ExquisiteCatBread/SpringReverb/README.md

# SpringReverb
Guitar effect based on reverb tank

See "Spring reverb project documentation.pdf"

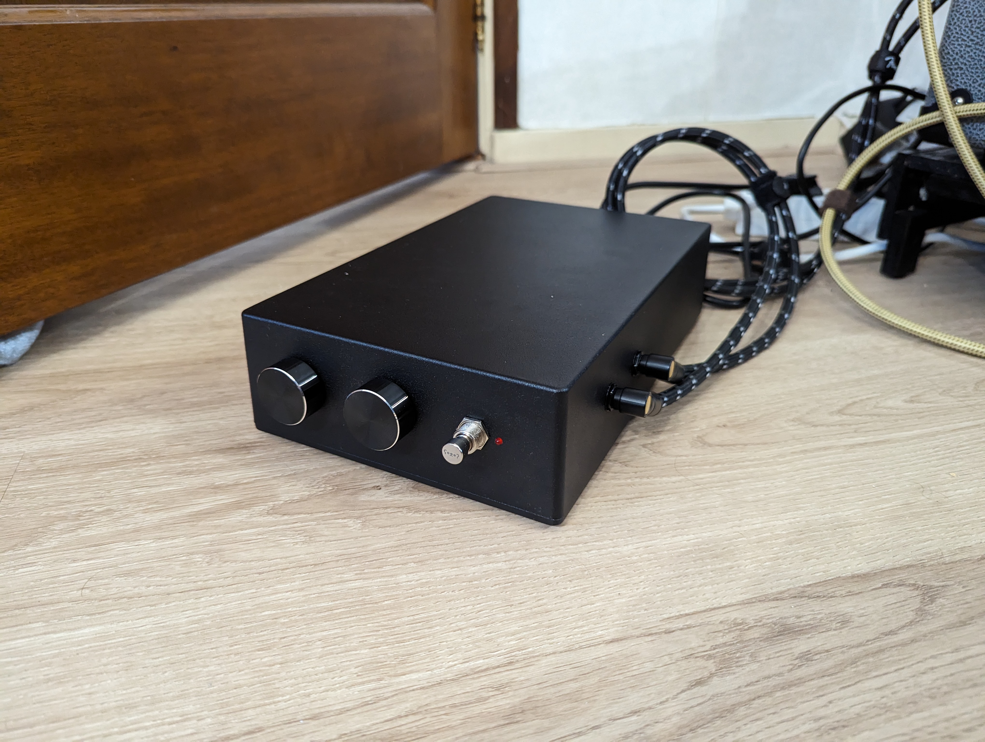
[picture p1: Pictures/SpringReverb(14).jpg]
SpringReverb
