ExquisiteCatBread/SpringReverb/Pictures/SpringReverb(1).jpg

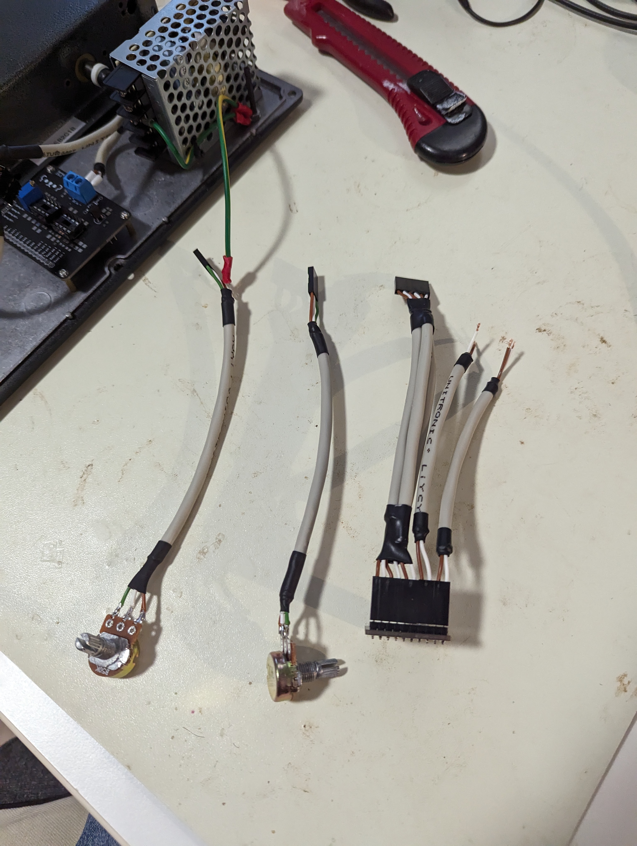
Pictures/SpringReverb(1).jpg
