ExquisiteCatBread/SpringReverb/Pictures/SpringReverb(2).jpg

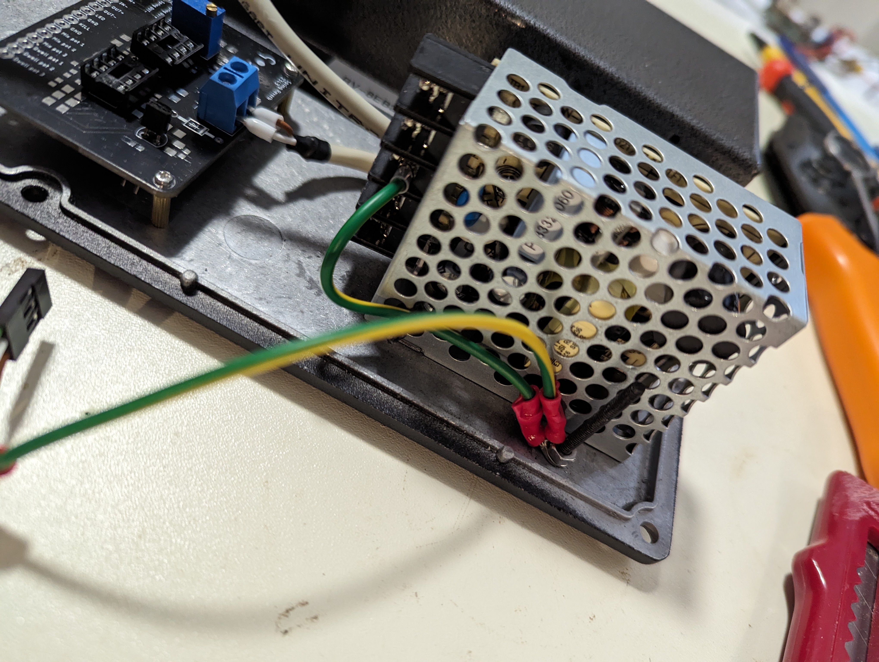
Pictures/SpringReverb(2).jpg
