ExquisiteCatBread/SpringReverb/Pictures/SpringReverb(3).jpg

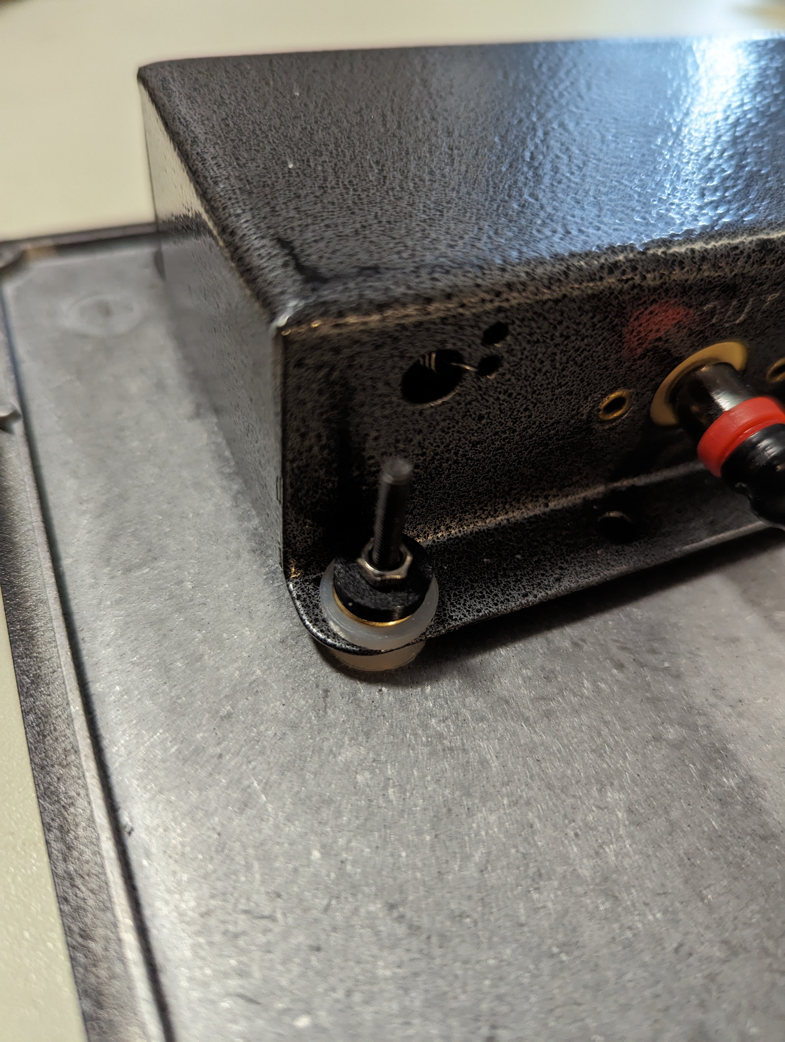
Pictures/SpringReverb(3).jpg
