ExquisiteCatBread/SpringReverb/Pictures/SpringReverb(4).jpg

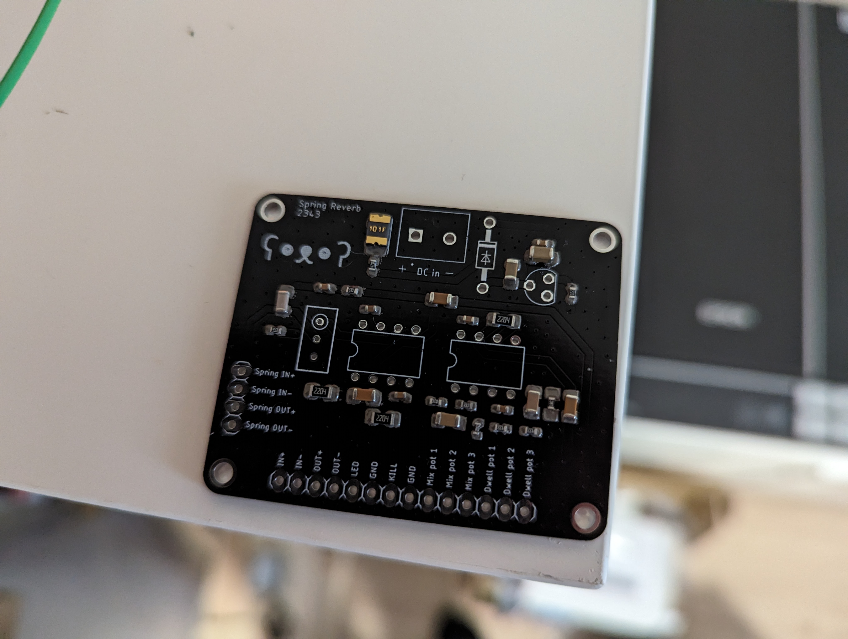
Pictures/SpringReverb(4).jpg
