ExquisiteCatBread/SpringReverb/Pictures/SpringReverb(5).jpg

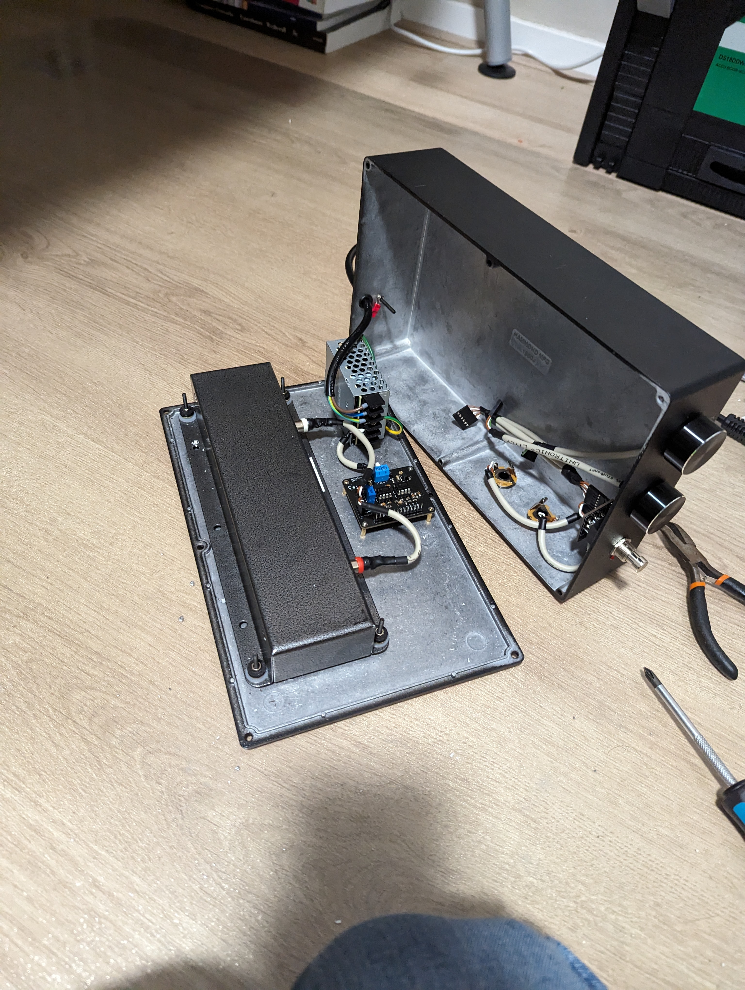
Pictures/SpringReverb(5).jpg
