ExquisiteCatBread/SpringReverb/Pictures/SpringReverb(6).jpg

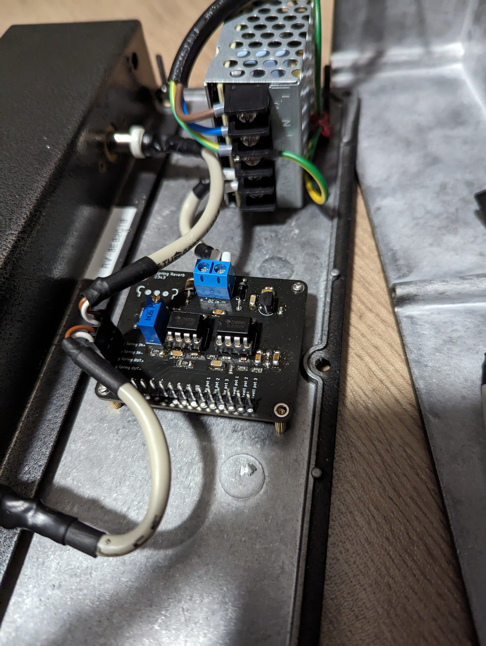
Pictures/SpringReverb(6).jpg
