ExquisiteCatBread/SpringReverb/Pictures/SpringReverb(7).jpg

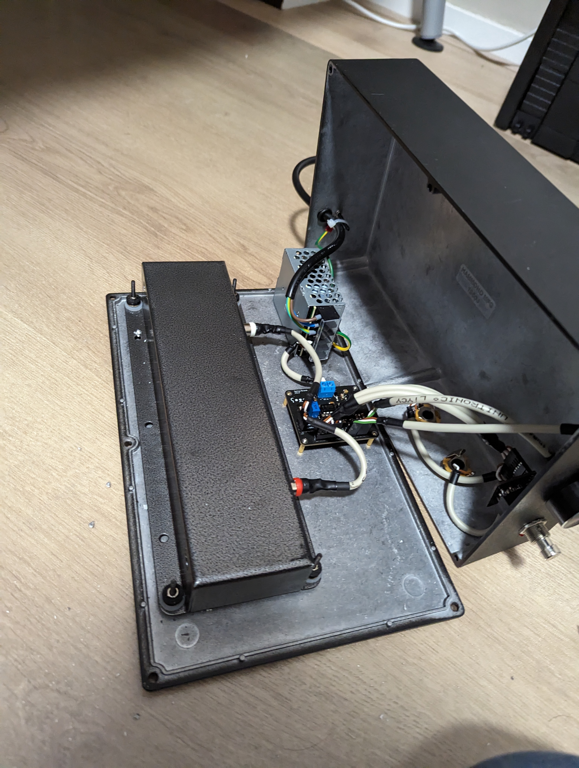
Pictures/SpringReverb(7).jpg
