ExquisiteCatBread/SpringReverb/Pictures/SpringReverb(8).jpg

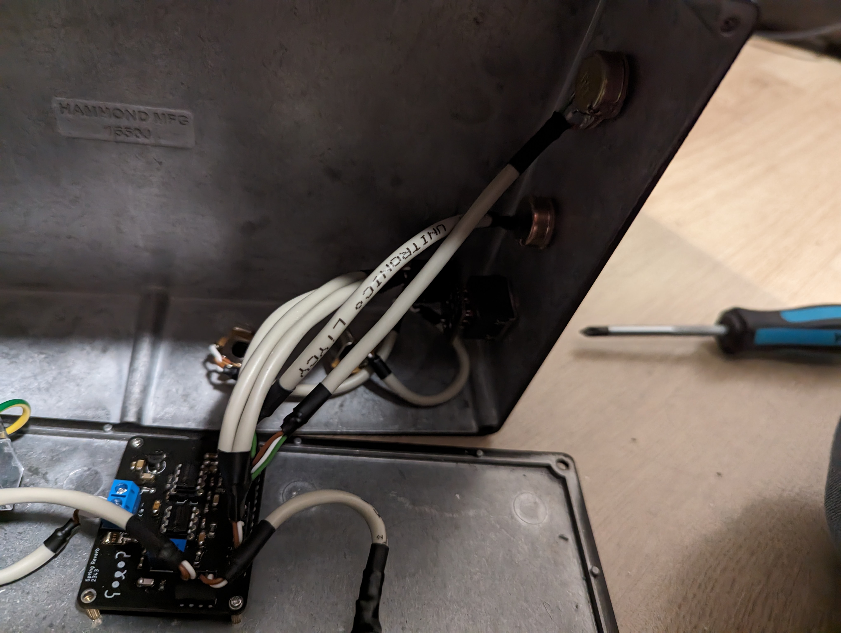
Pictures/SpringReverb(8).jpg
