ExquisiteCatBread/SpringReverb/Pictures/SpringReverb(9).jpg

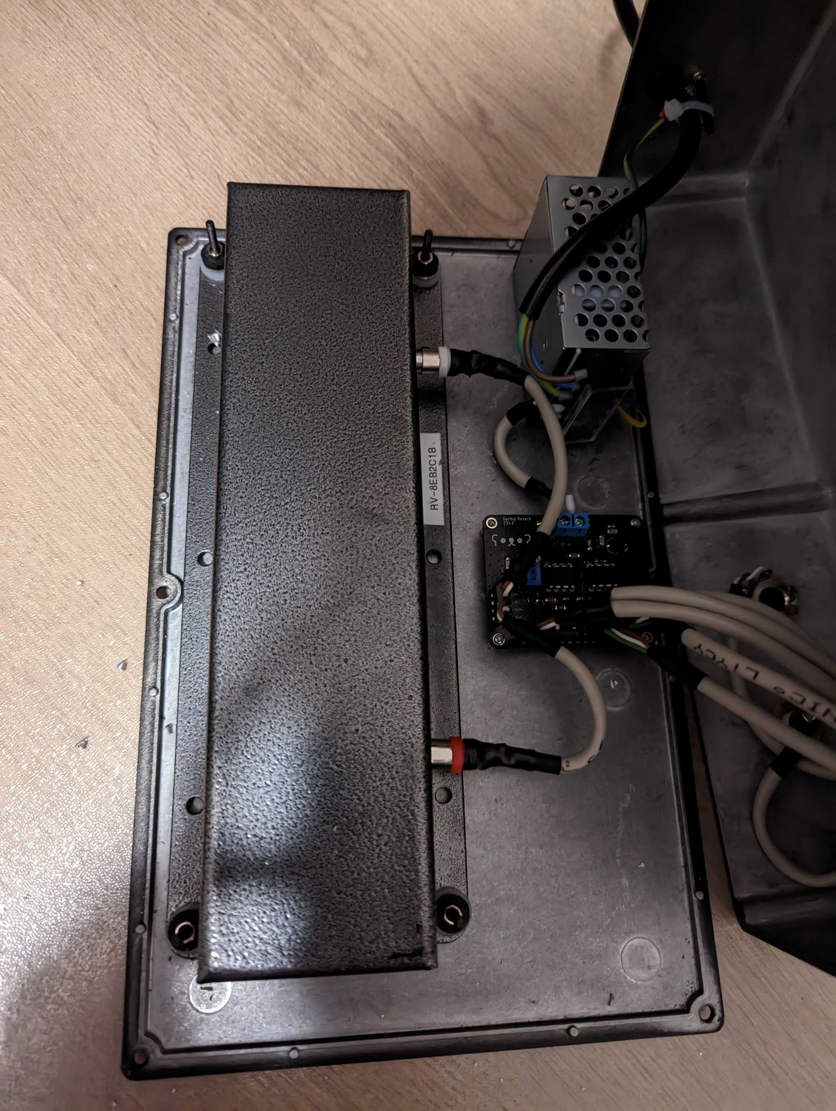
Pictures/SpringReverb(9).jpg
