ExquisiteCatBread/SpringReverb/Pictures/SpringReverb(10).jpg

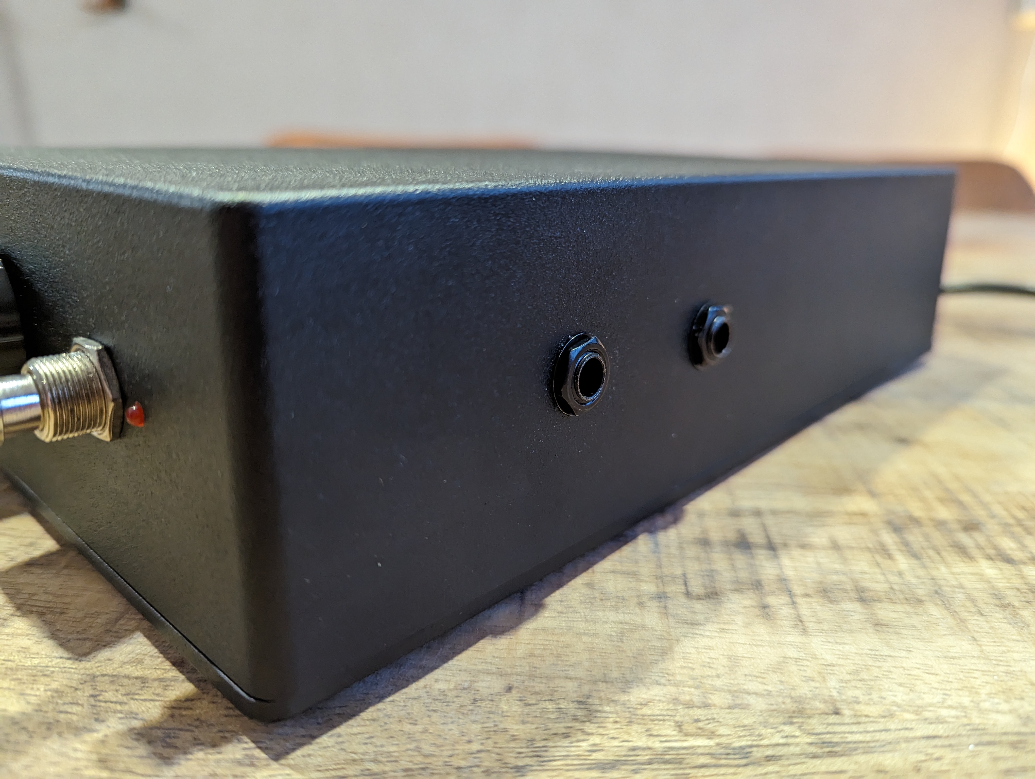
Pictures/SpringReverb(10).jpg
