ExquisiteCatBread/SpringReverb/Pictures/SpringReverb(11).jpg

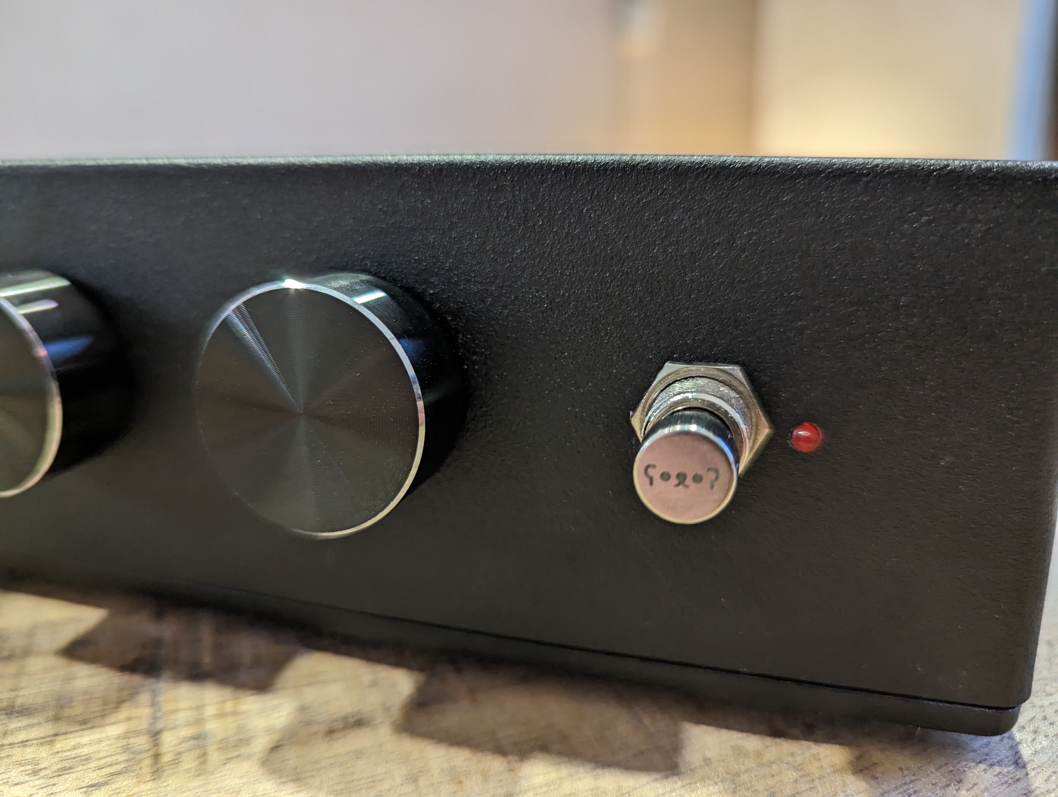
Pictures/SpringReverb(11).jpg
