ExquisiteCatBread/SpringReverb/Pictures/SpringReverb(12).jpg

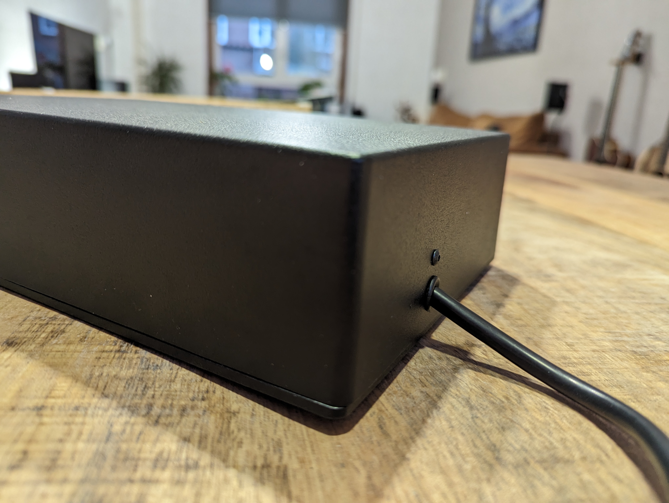
Pictures/SpringReverb(12).jpg
