ExquisiteCatBread/SpringReverb/Pictures/SpringReverb(13).jpg

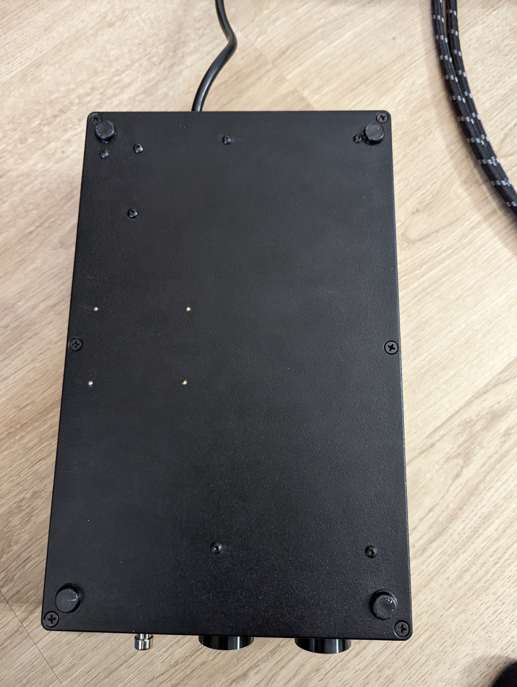
Pictures/SpringReverb(13).jpg
