ExquisiteCatBread/SpringReverb/Pictures/SpringReverb(15).jpg

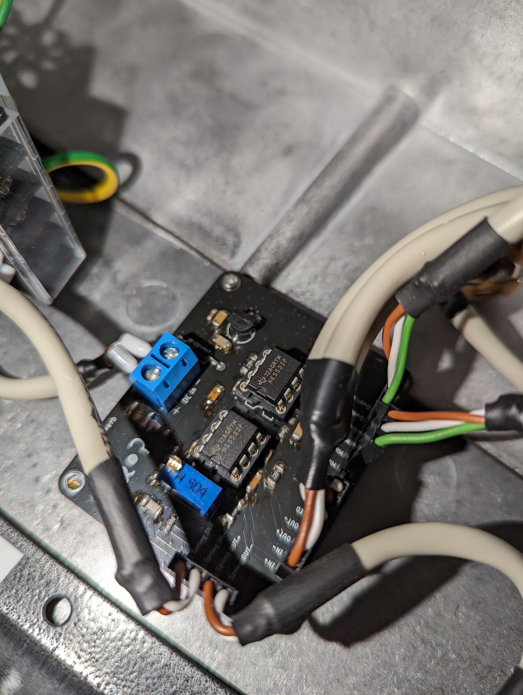
Pictures/SpringReverb(15).jpg
