ExquisiteCatBread/SpringReverb/Pictures/SpringReverb(16).jpg

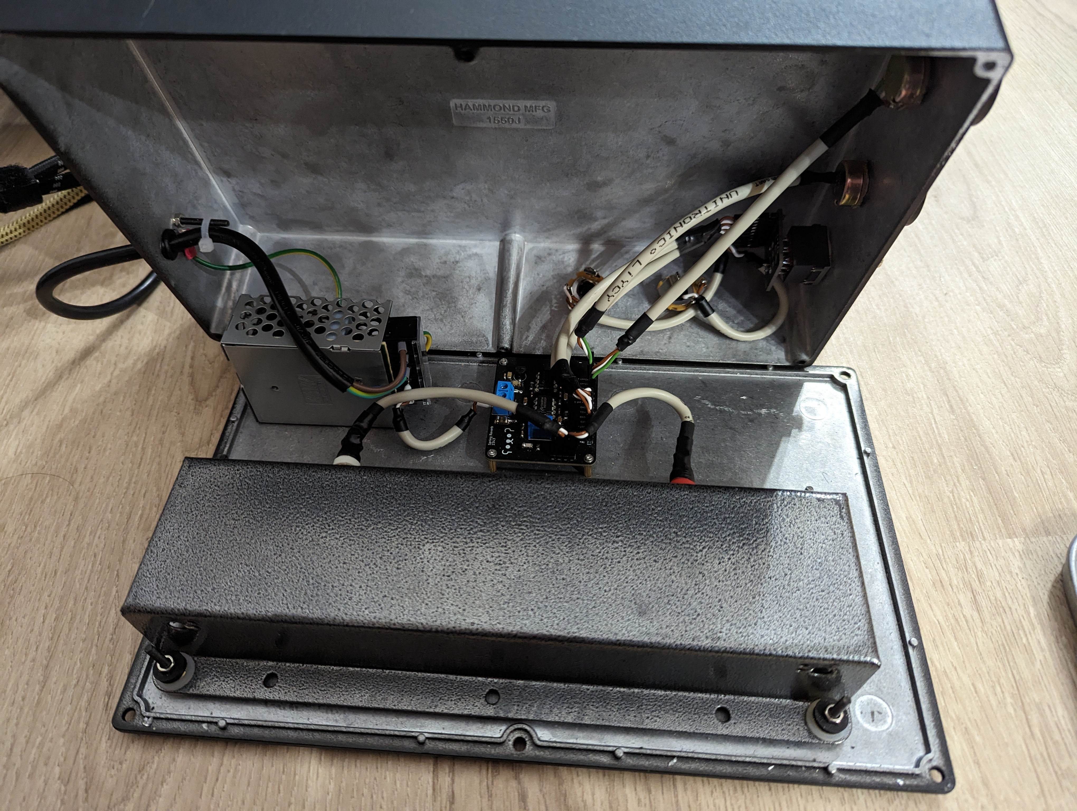
Pictures/SpringReverb(16).jpg
