ExquisiteCatBread/SpringReverb/Pictures/SpringReverb(17).jpg

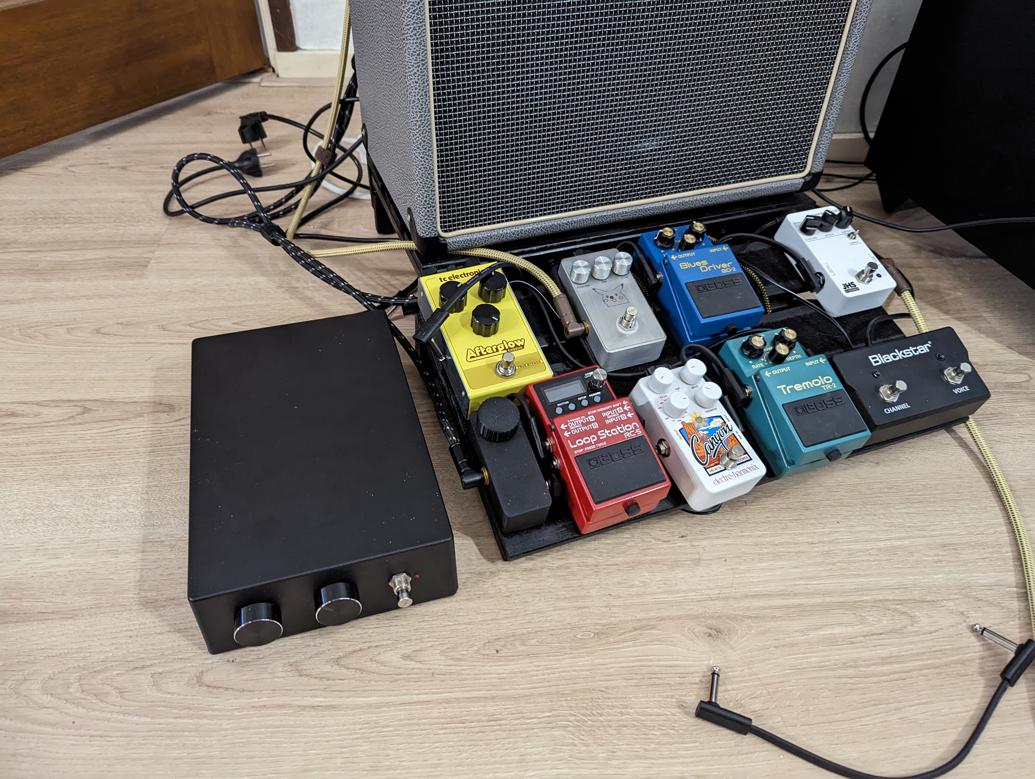
Pictures/SpringReverb(17).jpg
