ExquisiteCatBread/SpringReverb/Pictures/SpringReverb(18).jpg

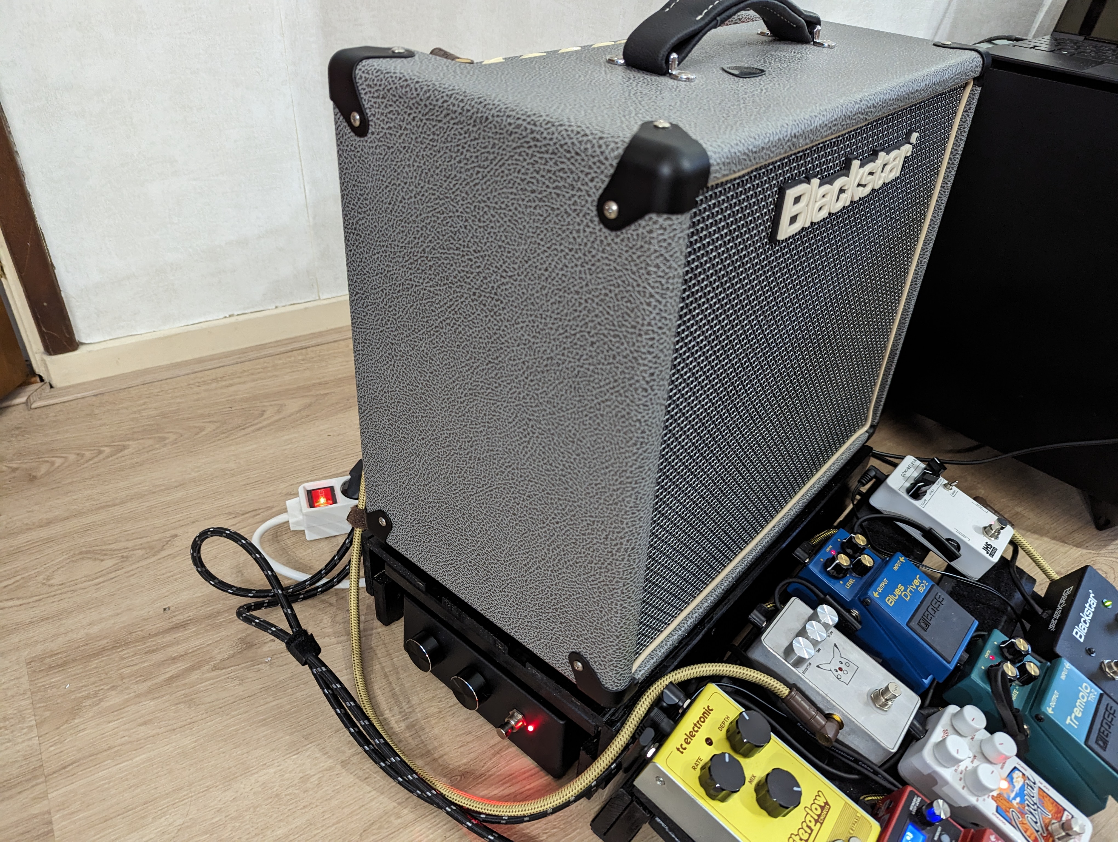
Pictures/SpringReverb(18).jpg
