ExquisiteCatBread/SpringReverb/Pictures/SpringReverb(20).jpg

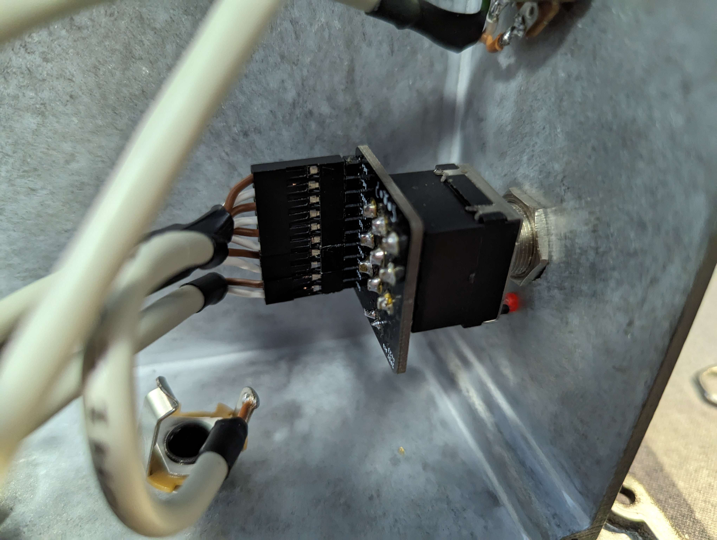
Pictures/SpringReverb(20).jpg
