ExquisiteCatBread/SpringReverb/Mounting spacers/Switch ring spacer v1.stl

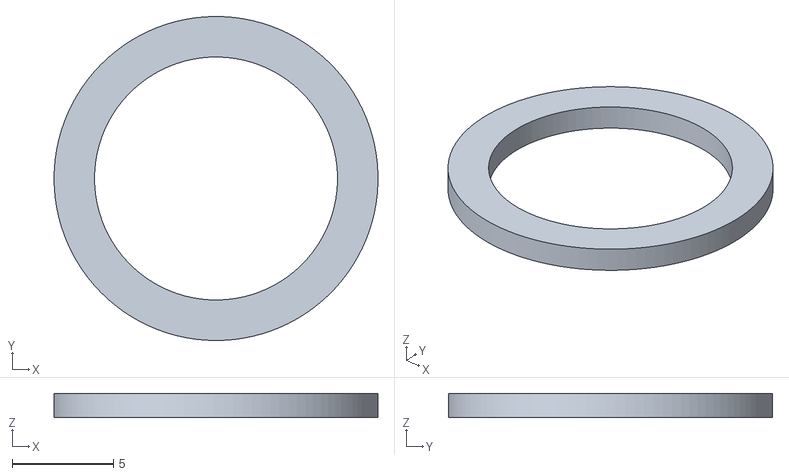
[picture p20: CAD file, 2023-11-24]
Mounting spacers/Switch ring spacer v1.stl
16.0 x 16.0 x 1.20
