ExquisiteCatBread/SpringReverb/Mounting spacers/Tank mount spacers v2.stl

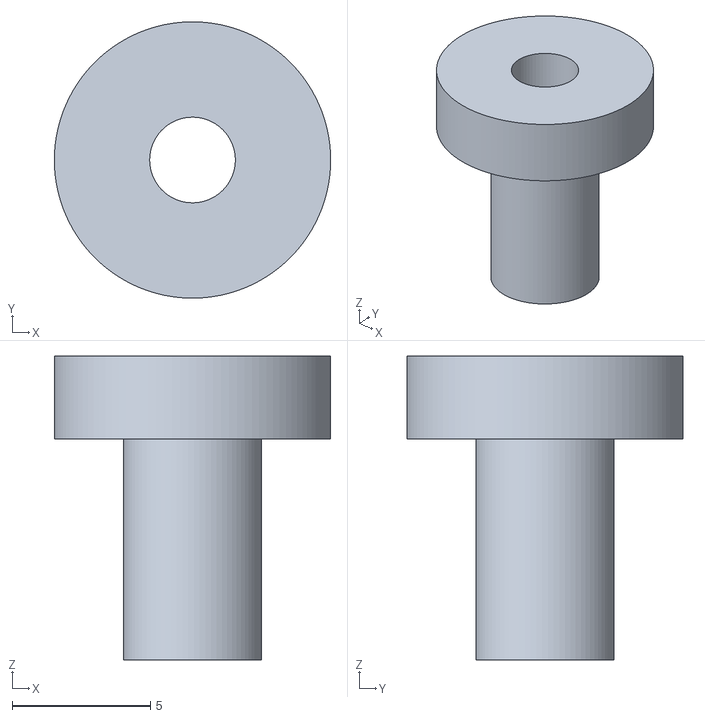
[picture p21: CAD file, 2023-11-04]
Mounting spacers/Tank mount spacers v2.stl
10.0 x 10.00 x 11.0
