ExquisiteCatBread/SpringReverb/(list of files, cad)

Other CAD files:
Mounting spacers/Switch ring spacer v1.f3d
Mounting spacers/Tank mount spacers v2.f3d
