ExquisiteCatBread/SpringReverb/PCB (Eagle)/SpringReverb.brd

## EAGLE design PCB (Eagle)/SpringReverb.brd (2023-11-08)

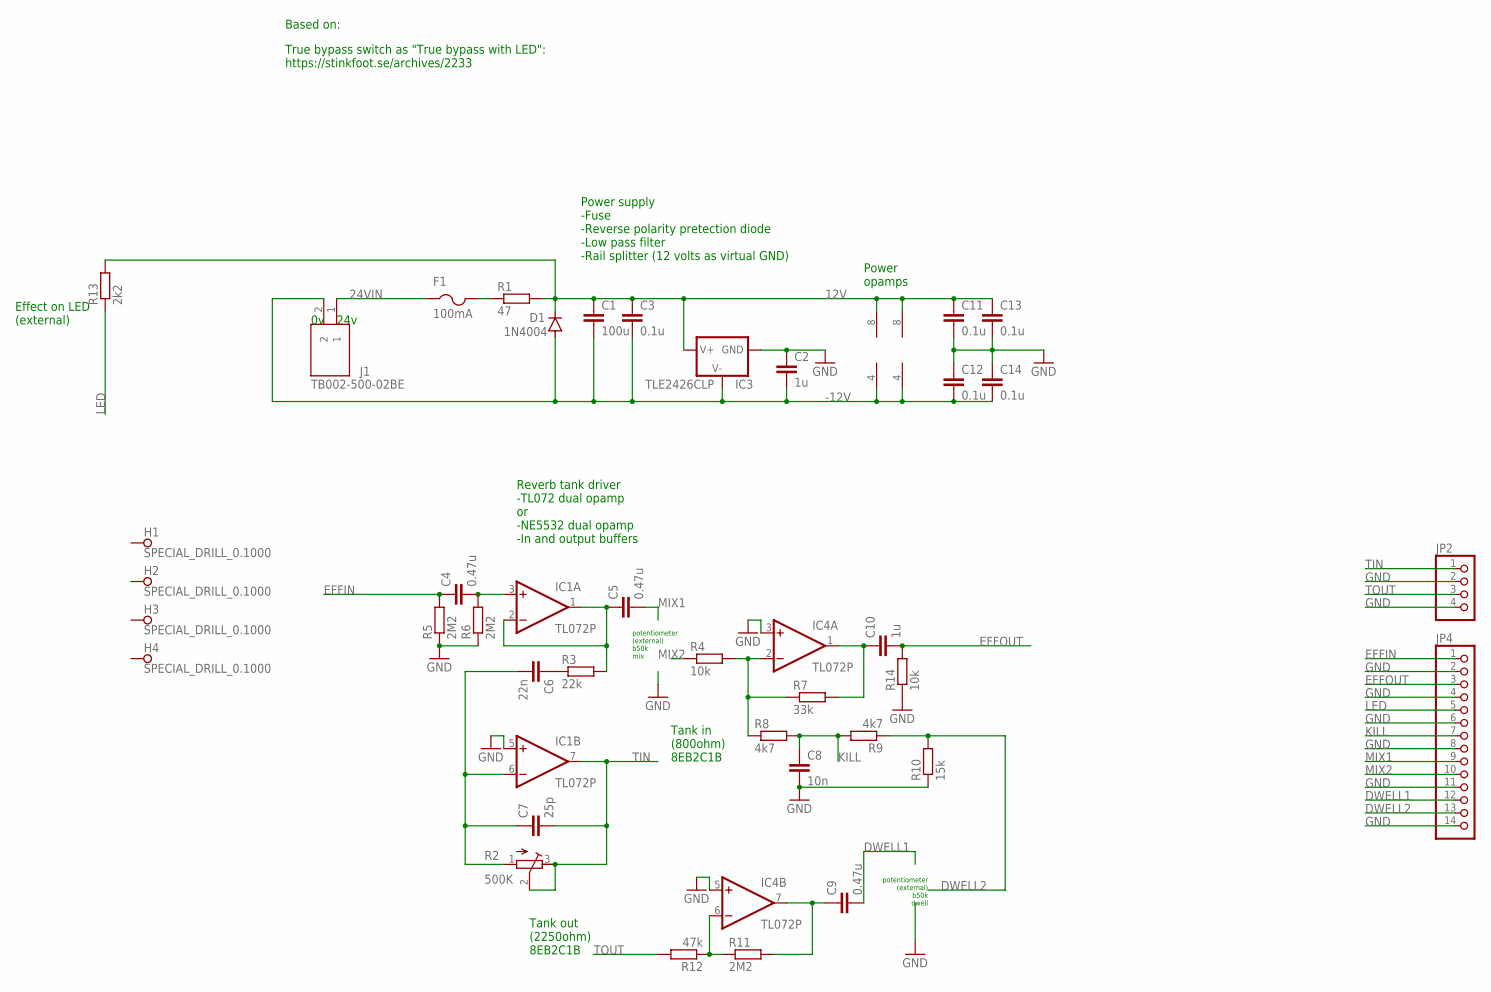
[picture p22: schematic SpringReverb.sch]

Parts:
C1: 100u; C1206
C2, C10: 1u; C1206
C3, C11, C12, C13, C14: 0.1u; C0603
C4, C5, C9: 0.47u; C1206
C6: 22n; C0603
C7: 25p; C1206
C8: 10n; C1206
D1: 1N4004; DO41-10
F1: 100mA; 1812
H1, H2, H3, H4: SPECIAL_DRILL_0.1000; PAD_0.1000
IC1, IC4: TL072P; DIL08
IC3: TLE2426CLP; TO92LP
J1: TB002-500-02BE; CUI_TB002-500-02BE
JP2: PINHD-1X4; 1X04
JP4: PINHD-1X14; 1X14
R1: 47; R0603
R2: 500K; RTRIM3296W
R3: 22k; R0603
R4, R14: 10k; R0603
R5, R6, R11: 2M2; R1206
R7: 33k; R0603
R8, R9: 4k7; R0603
R10: 15k; R1206
R12: 47k; R0603
R13: 2k2; R0603

Connections:
12V: C1.1, C3.1, C11.1, C13.1, D1.C, IC1.8 (V+), IC3.IN, IC4.8 (V+), R1.2, R13.2
24VIN: F1.1, J1.1
-12V: C1.2, C2.2, C3.2, C12.2, C14.2, D1.A, IC1.4 (V-), IC3.GND, IC4.4 (V-), J1.2
DWELL1: C9.2, JP4.12
DWELL2: JP4.13, R9.1, R10.2
EFFIN: C4.1, JP4.1, R5.2
EFFOUT: C10.2, JP4.3, R14.2
GND: C2.1, C8.2, C11.2, C12.1, C13.2, C14.1, IC1.5 (+IN), IC3.OUT, IC4.3 (+IN), IC4.5 (+IN), JP2.2, JP2.4, JP4.2, JP4.4, JP4.6, JP4.8, JP4.11, JP4.14, R5.1, R6.1, R10.1, R14.1
KILL: C8.1, JP4.7, R8.2, R9.2
LED: JP4.5, R13.1
MIX1: C5.2, JP4.9
MIX2: JP4.10, R4.1
unnamed: C4.2, IC1.3 (+IN), R6.2
unnamed: F1.2, R1.1
unnamed: C5.1, IC1.1 (OUT), IC1.2 (-IN), R3.2
unnamed: C6.1, R3.1
unnamed: C6.2, C7.1, IC1.6 (-IN), R2.1 (A)
unnamed: IC4.2 (-IN), R4.2, R7.1, R8.1
unnamed: C10.1, IC4.1 (OUT), R7.2
unnamed: C9.1, IC4.7 (OUT), R11.2
unnamed: IC4.6 (-IN), R11.1, R12.1
TIN: C7.2, IC1.7 (OUT), JP2.1, R2.2 (S), R2.3 (E)
TOUT: JP2.3, R12.2

Notes on the sheet:
Power supply -Fuse -Reverse polarity pretection diode -Low pass filter -Rail splitter (12 volts as virtual GND)
potentiometer (external) b50k mix
Reverb tank driver -TL072 dual opamp or -NE5532 dual opamp -In and output buffers
Based on:
potentiometer (external) b50k dwell
Effect on LED (external)
True bypass switch as "True bypass with LED": https://stinkfoot.se/archives/2233
24v
Power opamps
Tank in (800ohm) 8EB2C1B
Tank out (2250ohm) 8EB2C1B

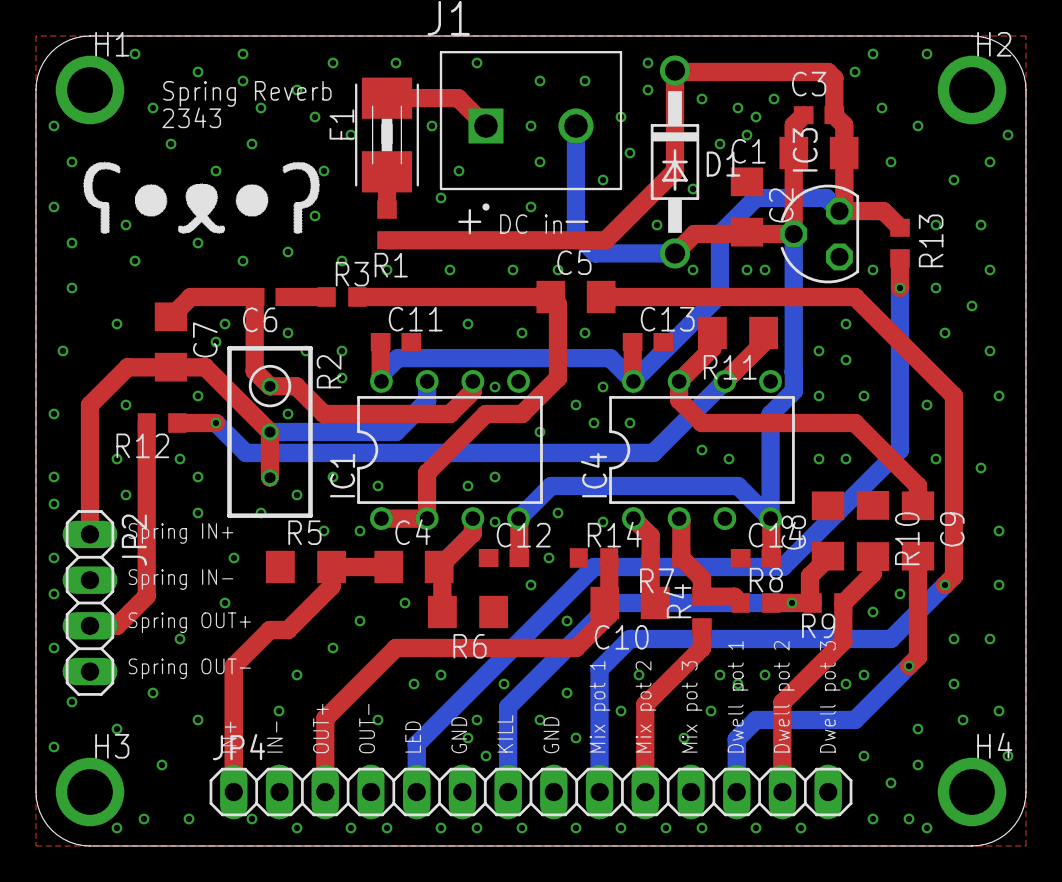
[picture p23: board SpringReverb.brd from above]

Board: 2 copper layers, 55.0 x 45.0 mm, 40 parts (0 on the bottom side), 23 nets.
