ExquisiteCatBread/SpringReverb/PCB (Eagle)/switch pcb.brd

## EAGLE design PCB (Eagle)/switch pcb.brd (2023-11-05)

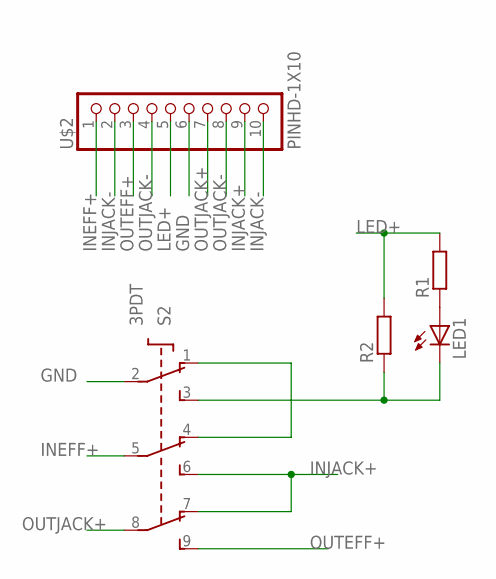
[picture p24: schematic switch pcb.sch]

Parts:
LED1: LED3MM
R1, R2: R-EU_R0603; R0603
S2: 3PDT
U$2: PINHD-1X10; 1X10-BIG

Connections:
GND: S2.2 (P1), U$2.6
INEFF+: S2.5 (P2), U$2.1
INJACK+: S2.6 (S2), S2.7 (O3), U$2.9
INJACK-: U$2.2, U$2.10
LED+: R1.2, R2.2, U$2.5
unnamed: LED1.A, R1.1
unnamed: LED1.K (C), R2.1, S2.3 (S1)
unnamed: S2.1 (O1), S2.4 (O2)
OUTEFF+: S2.9 (S3), U$2.3
OUTJACK+: S2.8 (P3), U$2.7
OUTJACK-: U$2.4, U$2.8

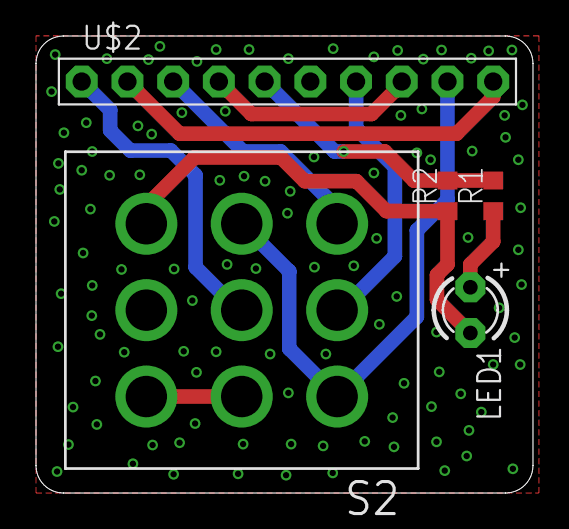
[picture p25: board switch pcb.brd from above]

Board: 2 copper layers, 27.6 x 25.4 mm, 5 parts (0 on the bottom side), 11 nets.
