ExquisiteCatBread/SpringReverb/(commit log)

2023-10-22 First
    first version of spring reverb driver pcb and 3pdt switch
    [SpringReverb.brd, SpringReverb.sch, switch pcb.brd, switch pcb.sch]
2023-11-04 Update first release PCB
    [SpringReverb.brd, SpringReverb.sch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]
2023-11-04 Update with doc
    [SpringReverb.sch, Tank mount spacers v2.f3d, Tank mount spacers v2.stl]
2023-11-05 Update switchPCB to version 4423
    Corrected footprint for 3PDT switch.
    Updated documentation.
    [copper_bottom.gbr, copper_top.gbr, drill_1_16.xln, gerber_job.gbrjob, profile.gbr, silkscreen_bottom.gbr, silkscreen_top.gbr, soldermask_bottom.gbr]
2023-11-08 Replaced C6
    Replaced C6 (0.1uF) with 22nF for less bass on tank input, therefore less muddy sound
    [SpringReverb.brd, SpringReverb.sch]
2023-11-11 Update Spring reverb project documentation.pdf
    Added BOM and cost calculation
2023-11-11 Update Spring reverb project documentation.pdf
2023-11-24 3pdt switch mounting
    Mounted 3pdt switch a bit better. with a 3d printed spacer ring. Replaced switch PCB with new version in photos.
    [Switch ring spacer v1.f3d, Switch ring spacer v1.stl]
